Mellini99/Seamless-Rehabilitation-Thesis-repository/README.md

# Seamless-Rehabilitation-Thesis-repository
Contains Arduino Code and assembly files for the prototype used in the thesis. Each folder contains their own readme file to explain how to use or assemply the prototype.
