Mellini99/Seamless-Rehabilitation-Thesis-repository/Prototype Assembly files/electric components schematic.png

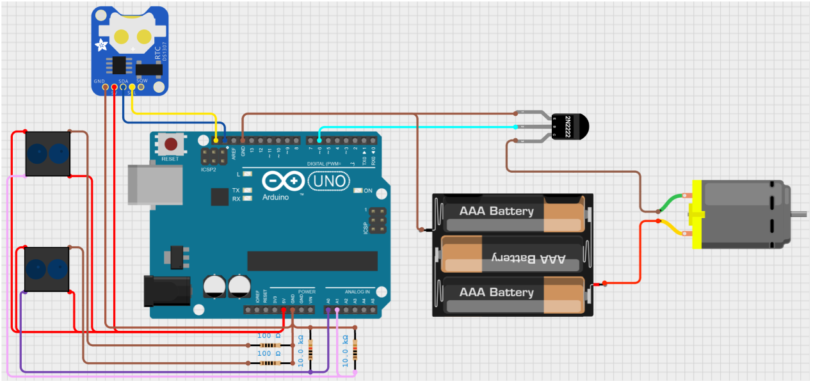
Prototype Assembly files/electric components schematic.png
