Mellini99/Seamless-Rehabilitation-Thesis-repository/(commit log)

2025-10-01 Read_out
    File to read out use data from the memory of the prototype
2025-10-01 Main_file
    File that defines a session and repetition, how to save it and how much soap to dispense per repetition as well as when to recalibrate the sensors. This file gets uploaded before using the prototype.
2025-10-17 Laser Cutting Outlines for 6cm radius
2025-11-18 Add schematics
2025-11-18 Add setup file arduino code
